MichaelDarr/updi-ki/README.md

# updi-ki

This project was forked from [Updi-Key](https://github.com/Dlloydev/Updi-Key).
