MichaelDarr/updi-ki/(commit log)

2024-01-07 Condense layout
    [updi_ki.kicad_pcb, updi_ki.kicad_sch]
2024-01-07 Remove unhelpful layers
    [updi_ki.kicad_pcb]
